pouyaasghari2002/centrifugal-pump-impeller-design/report/main.pdf

## Turbomachinery

# Centrifugal Pump Impeller Design

## Analytical Construction and CFturbo Modeling

Project One Report

## Pouya Asghari

## Niloufar Fattahi

Instructor: Dr. Riasi

Second semester of academic year 1404–1405 (Iranian calendar)

School of Mechanical Engineering

College of Engineering, University of Tehran

English translation of the original Persian report

Centrifugal Pump Impeller Design | Project One

## About this edition

This is an English translation of the supplied Persian project report. The two-phase structure, equations, numerical results, CAD construction sequence, and original substantive figures are retained. Screenshot interface labels and catalog extracts remain as originally supplied. Student identification numbers are omitted, and the coauthorship shown in the source is preserved. The spelling “Niloufar Fattahi” is a transliteration of the Persian author name.

The source uses “simulation” broadly for the CFturbo workflow. The archive documents analytical design, geometry generation, and preliminary software estimates; it does not include a separate CFD mesh, solver case, residual history, or validated flow-field results. Numerical and design claims in the translated body remain the original authors’ statements. An editorial appendix identifies discrepancies and compares the preliminary dimensions with parameters stored in the supplied native CFturbo file. It does not silently replace the original results.

## Contents

1 Introduction | 2
2 Phase One Analytical Design and Blade Construction | 2
3 Phase Two Impeller Modeling in CFturbo | 13
A Editorial Review and Saved Model Comparison | 31

## 1 Introduction

This project aims to develop the geometry, detailed drawings, and three-dimensional model of a centrifugal pump impeller for the 200-100 model, using the operating parameters and technical data in the Pumpiran catalog. The report is organized into two phases. In the first phase, the impeller blade geometry is designed step by step using the single-arc and double-arc methods, based on turbomachinery theory and the extracted pump duty point, and the final profile is drawn. In the second phase, the geometry and operating conditions at the catalog best efficiency point (BEP) are used for specialized pump modeling and simulation in CFturbo to examine flow behavior and design parameters.

## 2 Phase One Analytical Design and Blade Construction

### 2.1 Reference duty point and initial assumptions

The iso-efficiency curves in the Pumpiran catalog are examined at a rotational speed of N = 1450 rpm and an impeller diameter of D2 = 209 mm. The corrected operating coordinates below are adopted as the best efficiency point, with a maximum efficiency of 84.5%.

Volumetric flow rate: Q = 125 m³/h, equivalent to approximately 0.0347 m³/s.

Effective head: H = 13.5 m.

Shaft diameter at the coupling: ds = 32 mm. Allowing for hub thickness, the hub diameter is assumed to be dh = 45 mm.

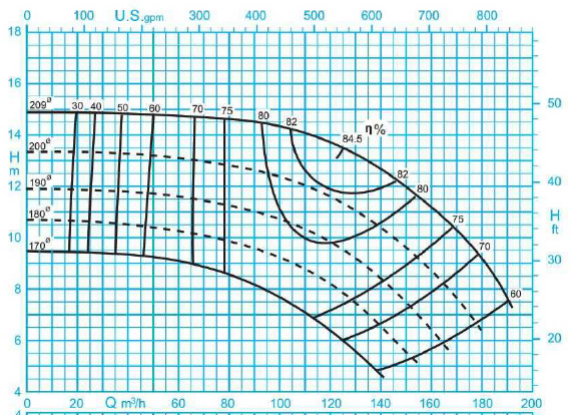
[picture p51: figure]

Figure 1: Pumpiran catalog performance curves used to select the reference duty point.

### 2.1.1 Design assumptions

Hydraulic efficiency: ηh = 0.90.

Volumetric efficiency: ηv = 0.96, allowing for 4% internal leakage.

Blade blockage factors: τ1 = 0.85 at the inlet and τ2 = 0.92 at the outlet.

Number of blades: Z = 6, adopted as a common choice for centrifugal water pumps.

Working fluid: water, with density ρ = 1000 kg/m³

### 2.2 Velocities and principal impeller dimensions

### 2.2.1 Step One Specific speed and theoretical head

The specific speed Ns is used to characterize the overall impeller form:

Ns =

N

√
Q
H⁰.75 =

1450√
0.0347
13.5

0.75 ≈ 38.3.

The source interprets this value as confirming a fully radial centrifugal pump. Applying the hydraulic efficiency gives the theoretical head:

Hth =

H
ηh

=

13.5
0.90

= 15.0 m.

### 2.2.2 Step Two Outlet velocity triangle and outlet angle

The peripheral speed at the outlet diameter D2 = 209 mm is

U2 =

πD2N
60

=

π(0.209)(1450)
60

= 15.87 m/s.

The tangential component of the fluid velocity, Cu2, follows from Euler’s equation:

Hth =

U2Cu2
g

=⇒ Cu2 =

15.0(9.81)
15.87

= 9.27 m/s.

Assuming a blade outlet angle of β

′

2 = 35◦
, the Stodola slip factor is calculated as

σ = 1 −

π sin 35◦

Z

= 1 −

π(0.573)
6

= 0.70.

The ideal tangential velocity is Cu2,∞ = 9.27/0.70 = 13.24 m/s. From the outlet velocity triangle, the outlet meridional velocity is

Cm2 = (U2 − Cu2,∞) tan β

′

2 = (15.87 − 13.24) tan 35◦ = 1.84 m/s.

The corrected flow rate is Q′ = Q/ηv = 0.0361 m³/s. The outlet blade width is therefore

b2 =

Q′

πD2Cm2τ2

=

0.0361
π(0.209)(1.84)(0.92) = 0.032 m = 32 mm.

### 2.2.3 Step Three Inlet dimensions and inlet angle

Taking the suction flange diameter of 125 mm as the reference, the impeller eye diameter is chosen as D1 = 125 mm. The effective inlet area is

A1 =

π
4

(D²
1 − d

2
h

) = π
4

(0.125² − 0.045²

) = 0.0107 m²

The inlet meridional velocity is

Cm1 =

Q′
A1

=

0.0361
0.0107

= 3.37 m/s.

The inlet peripheral speed is

U1 =

πD1N
60

=

π(0.125)(1450)
60

= 9.49 m/s.

Assuming zero inlet prewhirl, Cu1 = 0, the inlet relative-flow angle is

βf1 = arctan

Cm1
U1

= arctan

3.37
9.49
≈ 19.5

◦

Allowing for a suitable incidence angle, the inlet blade metal angle is set to β

′

1 = 25◦

The inlet blade width is

b1 =

Q′

πD1Cm1τ1

=

0.0361
π(0.125)(3.37)(0.85) = 0.032 m = 32 mm.

### 2.3 Blade geometry using single and double arcs

For the SolidWorks construction, the inlet radius is R1 = 62.5 mm and the outlet radius is R2 = 104.5 mm. Blade angles are measured from the tangents to the corresponding circles.

### 2.3.1 Single arc method

In this method, the entire blade profile is represented by one circular arc of constant radius Rarc:

Rarc =

R²

2 − R²
1
2(R2 cos β

′
2 − R1 cos β

′
1

)

Rarc =

104.5

2 − 62.5

2
2(104.5 cos 35◦ − 62.5 cos 25◦)

≈ 120.9 mm.

The source specifies a single-arc blade radius of 120.9 mm, with the arc center located at a radial distance of 69.6 mm from the shaft center.

Construction procedure First, draw two concentric circles with radii R1 and R2 in Solid-Works.


Figure 2: Concentric inlet and outlet circles for the single arc construction.

Choose an arbitrary point B on the outer circle and join it to the common center O. Select a point K on the inner circle so that ∠BOK = β

′
1 + β

′
2

:

β

′
1 + β

′

2 = 25◦ + 35◦ = 60◦


Figure 3: Selection of points B, O, and K with a central angle of 60 degrees.

Join B to K and extend the line until it intersects the inner circle again; call this intersection A. Draw the perpendicular bisector of BA. From B, draw a line at an angle β

′
2

to BO so that it
intersects the perpendicular bisector at G. Finally, draw an arc from B to A centered at G.


Figure 4: Single arc construction using the perpendicular bisector and center G.

To check the constructed arc, extend both ends and measure their angles relative to the circle tangents. As shown below, the source obtains the specified inlet and outlet angles, β

′
1

and β

′
2


Figure 5: Checking the inlet and outlet angles of the single arc profile.

Six blades are required. Use the Circular Sketch Pattern tool in SolidWorks to repeat the arc five more times.


Figure 6: Six blade profiles generated with Circular Sketch Pattern.

The following drawing also shows the inlet and outlet angles used in the construction.


Figure 7: Single arc blade construction with angle checks.

### 2.3.2 Double arc method

To improve flow guidance, the blade is divided into two sections. The source calls the intermediate radius Rm the geometric mean of the radii and defines it using the following expression:

Rm =

s
R²

1 + R²
2
2

= 86.1 mm.

With linear interpolation, the blade angle at the intermediate point is βm = 30◦ .

The first, inner arc extends from radius 62.5 mm at an angle of 25◦ to radius 86.1 mm at an
angle of 30◦
. The source calculates its radius as Rarc1 = 97.7 mm.

The second, outer arc extends from radius 86.1 mm at 30◦

to radius 104.5 mm at 35◦
. Its
reported radius is Rarc2 = 159.1 mm.

Construction procedure First, calculate δ using the procedure in the course’s impeller design video:

δ = D1 sin β

′

1 = 125 sin 25◦ = 52.827 mm.

Draw a circle of diameter δ centered at O, in addition to the two principal circles.


Figure 8: Auxiliary circle of diameter delta for the double arc construction.

Mark six points on the inner circle, and from each point draw a tangent to the circle of diameter δ.


Figure 9: Tangents drawn from the inlet circle to the auxiliary circle.

Using the tangent lengths as radii and the corresponding tangency points on the smallest circle as centers, draw circular curves. Continue each curve until it meets the extension of the next tangent. Each resulting segment forms part of the complete blade profile.


Figure 10: Construction of the initial curved segments.

Trim the unused portions of the circles.


Figure 11: Initial blade segments after trimming the auxiliary circles.

The partial blade profile is now visible. To continue the construction, determine the remaining arc radius ρ using

ρ =

1
2

R²

2 − R²
F
R2 cos β

′
2 − RF cos β

′
F

Here, RF is the distance from the impeller center to the end of the constructed curve. The source describes the relevant angle as the angle between RF and the line joining the curve endpoint to the first point on the δ circle, but labels it β

′
2

in this sentence. On that connecting line, locate point G a distance ρ from the curve endpoint, then draw a circle centered at G with radius ρ to join the curve to the outer circle. See the editorial note on the angle-label inconsistency.


Figure 12: Determination of the intermediate endpoint and connecting arc.

From the SolidWorks drawing above, the unknown quantities are obtained as

RF = 82.30 mm,

β

′

F = 5.26◦

ρ =

1
2

104.5

2 − 82.30²
104.5 cos 35◦ − 82.30 cos 5.26◦

=⇒ ρ = 568.39 mm.

Thus, locate the center a distance ρ from the end of the existing curve and draw a circle of radius ρ.


Figure 13: Construction of the final arc of radius 568.39 mm.

Trim the extra portions and check the inlet and outlet angles.


Figure 14: Angle checks after trimming the final connecting arc.

The drawing shows the specified inlet and outlet angles. The blade profiles are then redrawn without the auxiliary construction geometry.


Figure 15: Completed blade profiles without construction lines.

Table 1: Blade metal and relative-flow angles reported in Phase One.

Parameter | Value | Description

Inlet metal angle β

′

1 | 25◦ | Blade construction angle, including 5.5

◦
inci-
| | dence.
Outlet metal angle β

′

2 | 35◦ | Outlet construction angle used to draw the blade arc.
Inlet flow angle β1 | 19.5
- Relative inlet direction from the velocity triangle.
Outlet flow angle β2 | 15.6
- Actual relative outlet direction including slip.

## 3 Phase Two Impeller Modeling in CFturbo

After the initial geometric design in Phase One, Phase Two addresses the three-dimensional modeling and detailed simulation of the 100-200 pump impeller in CFturbo. The source describes the software as converting the extracted operating parameters and dimensions into a detailed CAD model and predicting the pump’s fluid behavior.

### 3.1 Entering the duty point

The CFturbo workflow starts by defining the pump operating conditions. The Phase One values for the best efficiency point are entered into the software:

Working fluid: water at the reference temperature, with a density of 1000 kg/m³

Rotational speed: N = 1450 rpm.

Volumetric flow rate: Q = 125 m³/h, equivalent to approximately 0.0347 m³/s.

Developed head: H = 13.5 m.

From these inputs, CFturbo calculates the specific speed and identifies the turbomachine as a radial centrifugal pump.


Figure 16: CFturbo global setup at the adopted duty point.

The proposed machine type is shown as Radial (medium pressure). The hydraulic efficiency was taken as 90% in Phase One, so the same value is entered here.


Figure 17: Duty point and efficiency settings.

From Add Component, choose Radial/Mixed-flow Impeller. Then select the options shown in the Setup tab of Main Dimensions. The source leaves Unshrouded unchecked so that the impeller has a front shroud, explaining this choice in terms of the water-pump application. Splitter Blades is also left unchecked; the source states that the pump size does not require additional outlet flow guidance of that type.


Figure 18: Radial impeller setup options.

In the Parameters tab, the default values are initially retained because they lie in suitable regions of the displayed parameter curves. The manually calculated value of b2/D2, however, falls outside the indicated recommended region and is considered unsuitable.


Figure 19: Initial parameter choices and warning messages.


Figure 20: Parameter chart for the outlet width ratio.

The b2/D2 parameter is therefore also returned to its default value.


Figure 21: Parameters after restoring the default width ratio.

In the Dimensions tab, select the shaft specification. The Pumpiran catalog lists Ck45 steel as the shaft material for the 100-200 pump.

Figure 22: Catalog material specification for the shaft, impeller, and casing.

The corresponding allowable stress is selected.

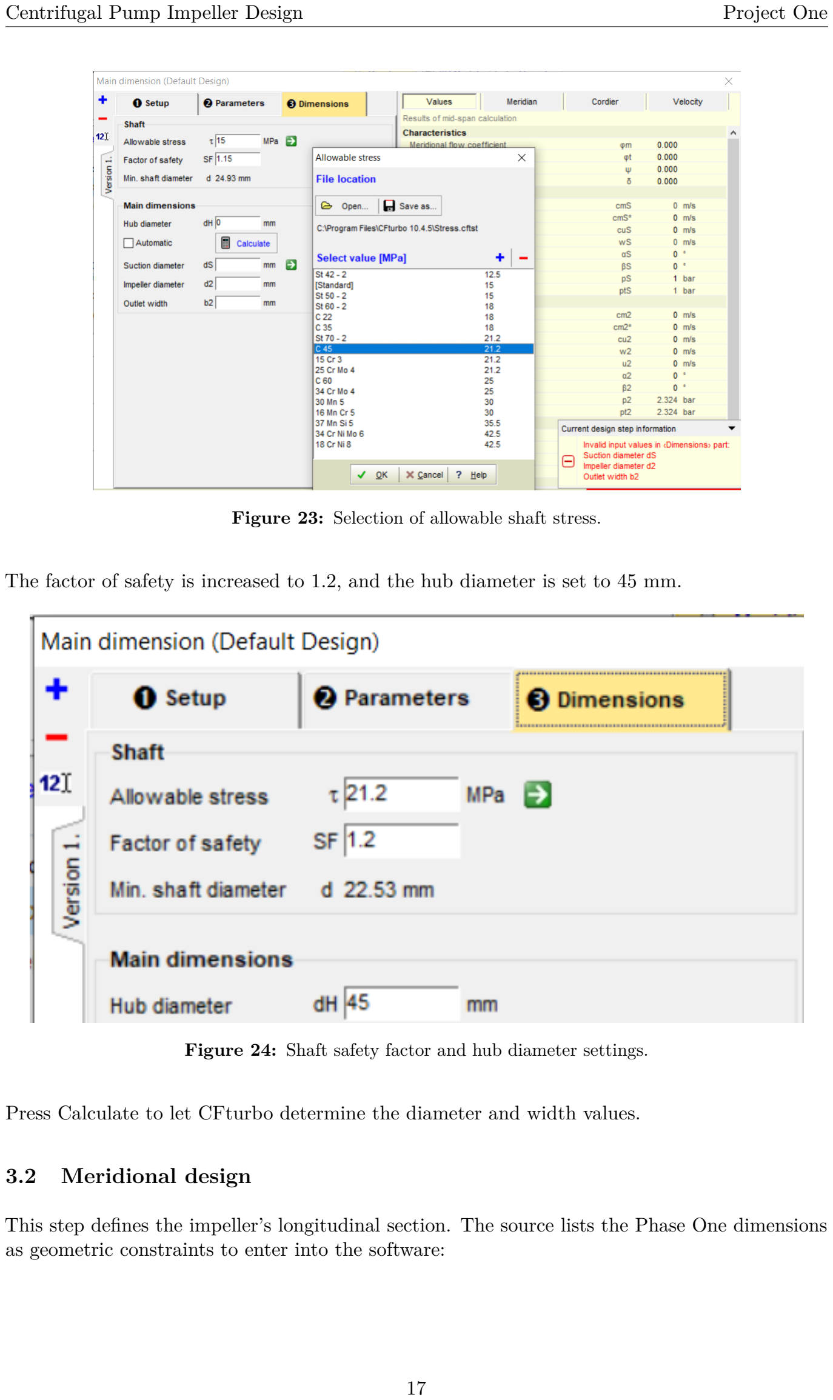
[picture p52: page 18]

Figure 23: Selection of allowable shaft stress.

The factor of safety is increased to 1.2, and the hub diameter is set to 45 mm.

Figure 24: Shaft safety factor and hub diameter settings.

Press Calculate to let CFturbo determine the diameter and width values.

### 3.2 Meridional design

This step defines the impeller’s longitudinal section. The source lists the Phase One dimensions as geometric constraints to enter into the software:

Table 2: Phase One dimensions listed as intended CFturbo inputs in the source.

Dimension | Symbol | Reported value
Shaft diameter | ds | 32 mm; hub diameter 45 mm
Impeller eye diameter | D1 | 125 mm
Impeller outlet diameter | D2 | 209 mm
Inlet blade width | b1 | 32 mm
Outlet blade width | b2 | 32 mm

The dimensions initially calculated by CFturbo are shown below.

Figure 25: Initial main dimensions proposed by CFturbo.

The source states that only the shaft diameter differs substantially from the Phase One values and proposes adjusting it using the standard diameter in the catalog. The following figures and the DN designation refer to the suction connection; this terminology conflict is addressed in the editorial appendix.


Figure 26: Catalog drawing showing the DN 125 suction connection.

From the Pumpiran catalog drawing above, the source identifies DN 125 as the standard nominal diameter.


Figure 27: Selection of a standard suction diameter.

The resulting parameter values are shown below.


Figure 28: Main dimension settings after adjustment.

The Cordier diagram available in the same dialog places the selected design point between the two red curves. The source treats this as an indication that the design is acceptable.


Figure 29: Cordier diagram for the selected operating point.

The velocity triangles are shown below.


Figure 30: CFturbo inlet and outlet velocity triangles.

The impeller hub and shroud contours are adjusted using Bezier curves in CFturbo, aiming for a smooth variation of passage area and avoiding abrupt changes in velocity.


Figure 31: Initial meridional contour and diagnostic plots.

Alongside the meridional blade view, the software displays Curvature, Cross Section Area, and Static Moment plots. The source states that lower specific speed calls for a straighter meridional centerline, while higher specific speed allows a more concave profile, as in this design. The cross-sectional area curve should preferably be smooth, with no sudden jumps; the initial geometry already satisfies this visual criterion. The two static-moment curves should preferably be close to each other. Small adjustments to the Bezier control points improve this plot.


Figure 32: Meridional diagnostic plots after adjusting the Bezier curves.

The impeller is mounted on the shaft using a shaft-end nut. On the suction side, this nut occupies part of the inlet flow area. The source therefore extends the hub contour forward relative to the shroud contour, aiming to reduce the obstruction of the effective suction area and improve entry into the flow passage.


Figure 33: Hub contour extended toward the inlet relative to the shroud.

### 3.3 Blade angles and thickness distribution

This is identified as the principal blade-design step in CFturbo. The geometric angles calculated in Phase One are initially specified as follows:

Number of blades: six.

Inlet blade metal angle: β

′

1 = 25◦

Outlet blade metal angle: β

′

2 = 35◦

The blade-angle distributions from inlet to outlet on the hub and shroud surfaces are refined using CFturbo’s conformal-mapping diagrams. The source also describes a gradual thickness distribution for the cast-iron blades, with a thinner leading edge to reduce incidence and blockage and a thicker trailing edge for mechanical strength.

With a specific speed of approximately 38, the source adopts the course recommendation to use Free-form 3D geometry above a specific speed of 15. Although this option is more expensive to manufacture than a two-dimensional blade, the source expects better efficiency and describes the choice as a tradeoff between efficiency and cost.

The proposed blade thickness range is 3.2–3.7 mm. A value of 3.4 mm is selected at the hub for both the leading and trailing edges, while 3.2 mm is selected at the shroud to create a spanwise thickness gradient. The source explains that this gradient facilitates removal from a casting mold compared with a uniformly thick blade. The blade count remains six, and Number of Spans is set to seven. The source treats this setting as a finer geometric subdivision rather than a change to the other design parameters. The remaining choices are shown below.

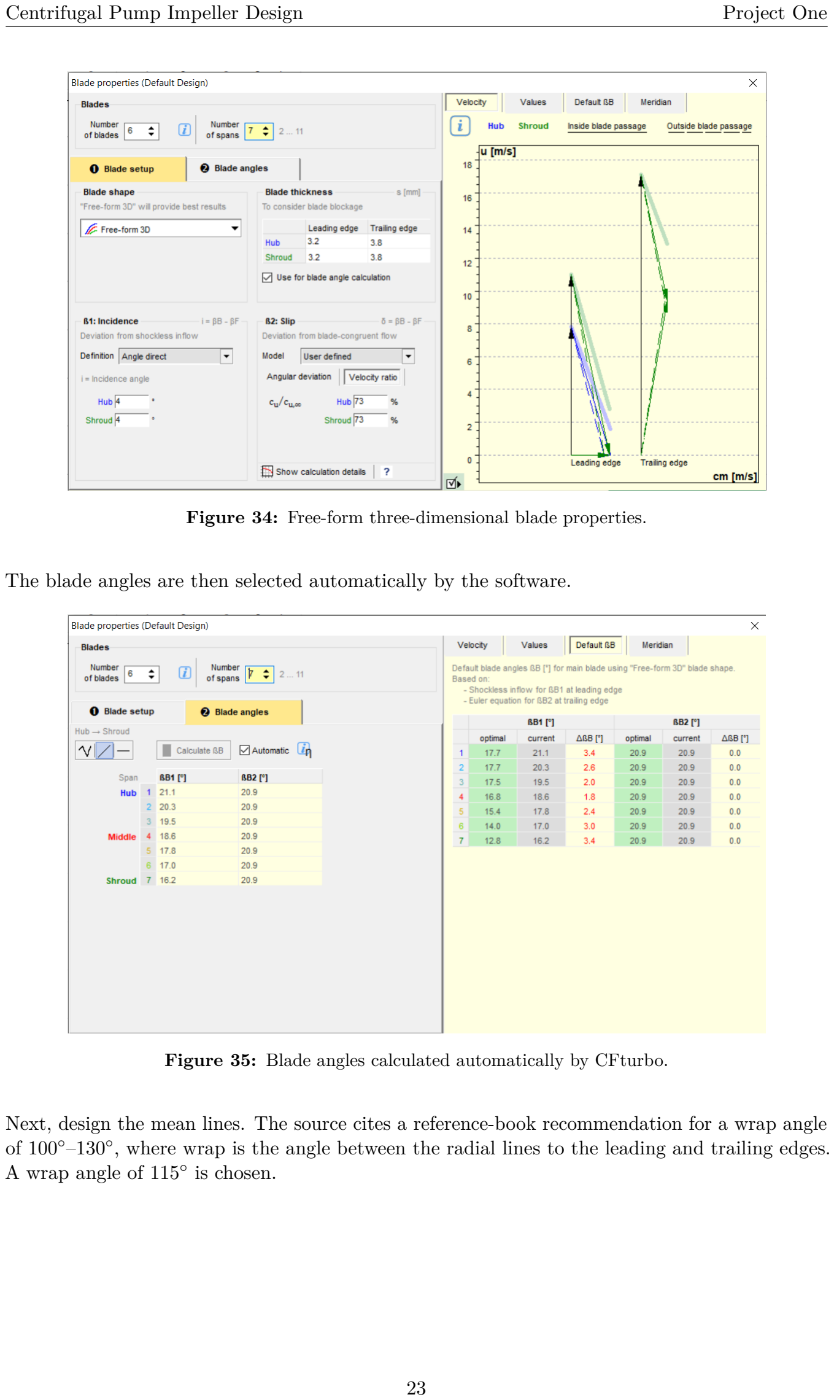
[picture p53: page 24]

Figure 34: Free-form three-dimensional blade properties.

The blade angles are then selected automatically by the software.

Figure 35: Blade angles calculated automatically by CFturbo.

Next, design the mean lines. The source cites a reference-book recommendation for a wrap angle of 100◦–130◦
, where wrap is the angle between the radial lines to the leading and trailing edges. A wrap angle of 115◦
is chosen.

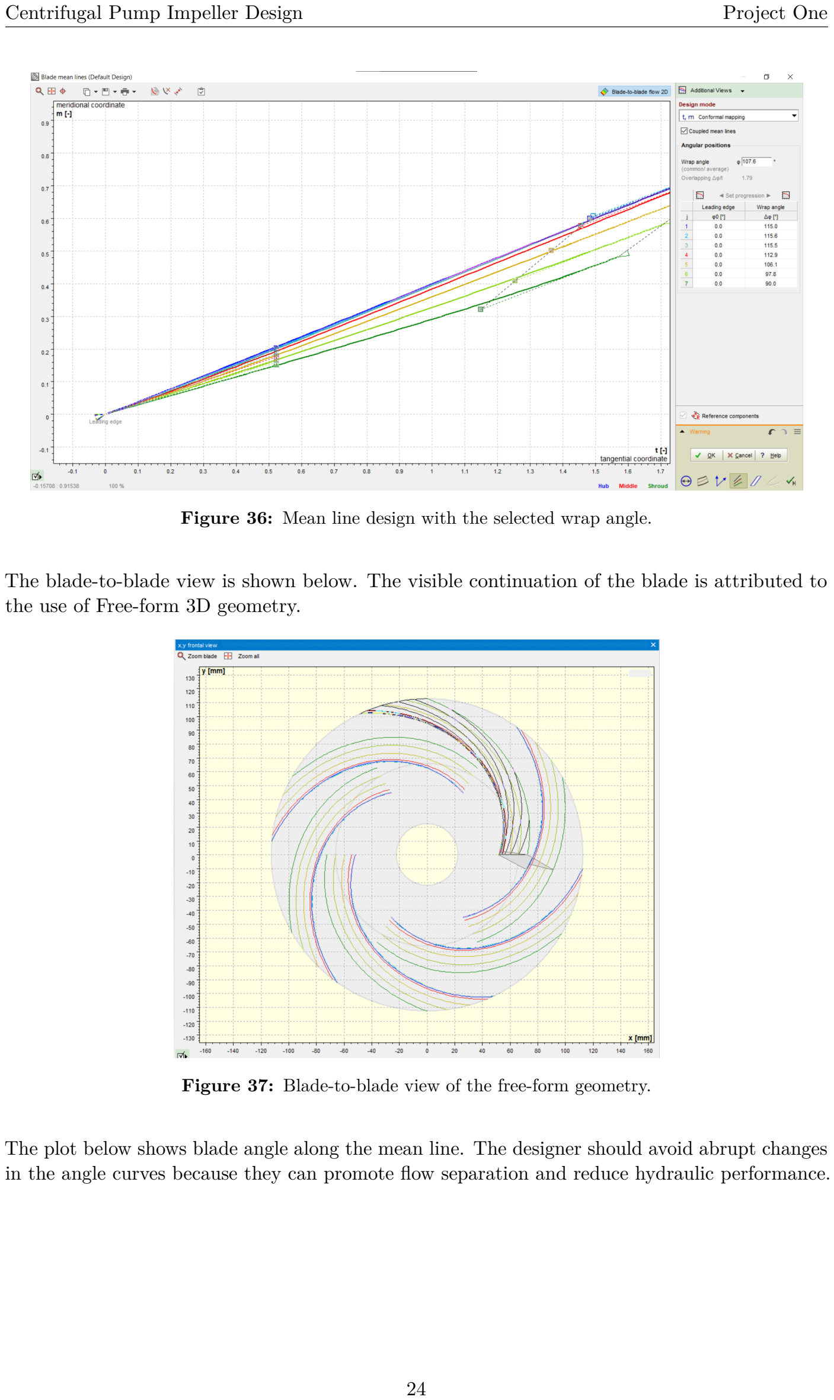
[picture p54: page 25]

Figure 36: Mean line design with the selected wrap angle.

The blade-to-blade view is shown below. The visible continuation of the blade is attributed to the use of Free-form 3D geometry.

Figure 37: Blade-to-blade view of the free-form geometry.

The plot below shows blade angle along the mean line. The designer should avoid abrupt changes in the angle curves because they can promote flow separation and reduce hydraulic performance.


Figure 38: Blade angle distributions along the mean lines.

### 3.4 Leading and trailing edge design

Blade-edge location directly affects hydraulic behavior. The leading edge is placed in the impeller eye region, and the trailing edge at the outer diameter D2. The source describes inclined edge geometry as a way to reduce stress concentration and provide smoother fluid entry.

The source recommends rounded, blade-like edge profiles rather than blunt, flat edges, describing the latter as producing stagnation and reduced hydraulic performance. It also calls for similar edge shapes from hub to shroud. These qualitative design statements are retained from the original report.


Figure 39: Leading and trailing edge profile settings.

Figure 40: Repeated edge-design view retained from the original report.

The same blade-like profile can also be observed in the front view.


Figure 41: Front view of the blade edge geometry.

### 3.5 Preliminary assessment in CFturbo

The source presents the CFturbo stage as an initial performance assessment and geometric-design check before more detailed CFD analysis.

The final three-dimensional impeller geometry can now be viewed.


Figure 42: Three-dimensional view of the impeller design.


Figure 43: Top view of the impeller geometry.


Figure 44: Side detail of the impeller geometry.

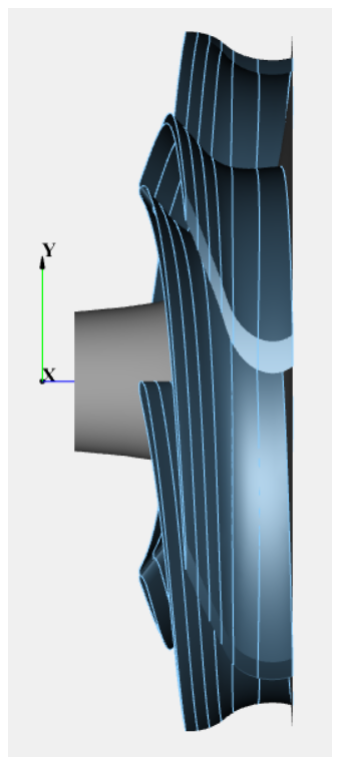
[picture p55: figure]

Figure 45: Axial side view of the impeller.

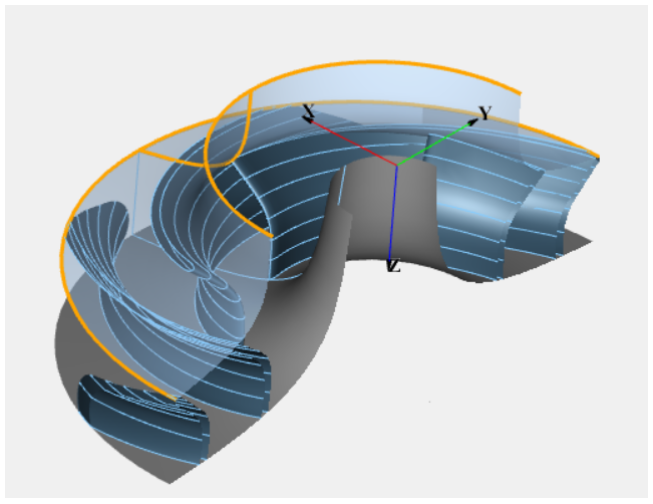
[picture p56: figure]

Figure 46: Perspective detail showing the blade passage.

Under Impeller, open Model Finishing and select Extend Blade Only.


Figure 47: Model finishing with Extend Blade Only selected.

Export the model in STEP and SWB formats.

### 3.6 Assessment objectives and workflow

Velocity and pressure assessment. The source describes analytical and semi-empirical estimates of relative velocity and static pressure along the interblade passage, intended to help identify regions susceptible to abrupt pressure reduction.

Cavitation assessment. The source discusses examining low-pressure regions near the leading edge and estimating the required net positive suction head, NPSHr. For this pump, the design should be checked so that the local pressure does not fall below the vapor pressure of water. The figure below contains empirical NPSHr estimates; it does not establish a resolved cavitating-flow simulation.

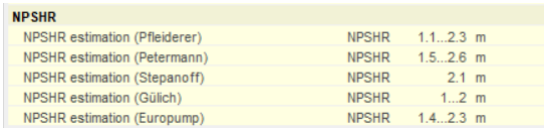
[picture p57: figure]

Figure 48: Empirical NPSHr estimates displayed by CFturbo.

Blade loading. The source proposes examining the pressure difference between the suction and pressure surfaces. A smooth loading distribution is described as desirable for limiting separation losses. An abrupt reduction in loading would motivate revising the blade-angle curves. No resolved blade-pressure dataset is supplied in the archive.

Three-dimensional outputs and model transfer. After reviewing the preliminary calculations, dimensions, and angles, the final impeller geometry is prepared for CAD export. Standard formats such as STEP or IGES can transfer geometry to fluid-analysis environments such as ANSYS CFX or Fluent, or to CAD systems such as SolidWorks. The supplied archive contains STEP and SWB exports; IGES and downstream CFD cases are not included.


Figure 49: CAD views of the impeller after geometry transfer.

The source concludes that the final CFturbo model agrees reasonably with the Phase One calculations and offers a basis for physical manufacture or more detailed numerical testing. This conclusion is retained as the authors’ assessment; the saved-model differences and the absence of independent validation are documented in the editorial appendix.

## A Editorial Review and Saved Model Comparison

This appendix was added during English preparation. It distinguishes the source report from values inspected in the supplied files. The CFturbo and SolidWorks projects have not been opened or recomputed in their native applications.

A.1 Project scope and validation status

The archive contains one Persian report, a CFturbo design file, a STEP export, a SolidWorks macro, two main SolidWorks parts, and two further parts in a folder named Junk. No CFD solver project, mesh, flow-field dataset, or experimental test results were supplied. Empirical NPSHr estimates and geometric diagnostic curves do not demonstrate a cavitation simulation or validate pump performance. The quoted 84.5% catalog efficiency is a source datum, while the 90% hydraulic efficiency is a design assumption; neither is a measured efficiency of the new impeller.

The source identifies the pump as both 200-100 and 100-200. The repository uses the descriptive project name instead of asserting that these are distinct pump models. The full Pumpiran catalog and the unspecified course reference book were not supplied as standalone references.

A.2 Hand calculations and terminology

The source’s single arc formula gives approximately 121.11 mm when evaluated using R1 = 62.5 mm, R2 = 104.5 mm, β

| ′

1 = 25◦
, and β

′

2 = 35◦
, rather than the stated 120.9 mm. This small discrepancy should be reconciled with the exact sketch dimensions before manufacturing use.

The expression q
(R²
1 + R²
2

)/2 = 86.1002 mm is the root mean square of the radii, not their geometric mean. The geometric mean would be √
R1R2 = 80.8161 mm. The source’s expression and reported 86.1 mm are retained in the translated body.

Using the same arc-radius formula with the stated intermediate radius and angles gives about 97.85 mm and 158.88 mm, close to the reported 97.7 mm and 159.1 mm. The later tangent-based drawing uses a different continuation construction and a radius of 568.39 mm. These are different constructions in the source; the report does not establish their equivalence.

For that final continuation, the angle associated with RF is β

′
F = 5.26◦
. The explanatory source
sentence calls it β

′
2

, although β

′

2 = 35◦
is the separate outlet angle. The displayed equation and the reported 568.39 mm use the intended β

′
F

notation.

The specific speed near 38.36 uses N in rpm, Q in m³/s, and H in meters. This is the conventional European-style specific-speed value often denoted nq; numerical specific-speed values depend on the unit convention and should not be compared across conventions without conversion.

A.3 Suction connection and shaft diameter

DN 125 describes the nominal suction connection shown in the catalog drawing; it is not a shaft diameter. The source separately gives a 32 mm coupling-shaft diameter and a 45 mm hub diameter. In the CFturbo main-dimensions interface, the suction-diameter field and the shaft sizing section are separate. The source’s narrative confuses them during the standard-diameter selection step.

A catalog flange designation also does not by itself require the internal impeller eye diameter to be exactly 125 mm. That value is an assumption in the preliminary hand design. A point within the displayed Cordier recommendation region is a design heuristic, not independent hydraulic or mechanical validation.

A.4 Parameters stored in the native CFturbo project

The project XML records CFturbo version 10.4.5.27, with format version 10.4. Its global setup stores a rotational frequency of 24.1667 s

−1
(1450 rpm), a mass flow of 34.7222 kg/s, density 1000 kg/m³

, and specific energy 132.435 J/kg. These correspond to 125 m³/h and a head of 13.5 m using g = 9.81 m/s

2

The following are stored parameter values, not independently regenerated geometry measurements:

Table 3: Preliminary design versus the supplied saved CFturbo state.

Quantity | Preliminary report | Saved project
Outlet diameter | 209 mm | 225.8 mm
Outlet width | 32 mm | 34.55 mm
Eye or suction diameter | Eye assumed 125 mm | Suction field 132.5 mm
Hub diameter | 45 mm | 45 mm
Blade count | 6 | 6
Span count | 7 in CFturbo stage | 7
Blade form | Free-form 3D selected | FreeForm
Shroud and splitters | Shrouded, no splitters | Same settings
Hydraulic efficiency | 0.90 assumption | Global EtaC 0.90; component
| | EtaH 0.912

The saved component stores inlet-angle entries of approximately 21.10◦ and 16.17◦
, and outlet-angle entries of approximately 20.89◦ at both listed endpoints. The preliminary 25◦ and 35◦ angles therefore do not describe the final saved blade-angle values. This is consistent with the narrative later allowing automatic angle calculation, but the stages must not be presented as identical.

Similarly, the saved thickness arrays contain 3.2 mm entries for s1 and 3.8 mm entries for s2, which differ from the prose’s proposed hub and shroud values. Their exact leading/trailing and span assignments should be confirmed in CFturbo before claiming a particular final thickness distribution. The native file also stores some empirical coefficients independently of the resulting manually adjusted dimensions; a saved coefficient should not be assumed to equal a ratio recomputed from all final dimensions.

A.5 CAD deliverables and reproducibility

The STEP export contains solid-body, surface, and curve entities. It should not be described as one verified watertight manufacturing solid merely because the filename ends in .stp. The native SolidWorks part files have not been inspected in SolidWorks, so their association with a particular blade construction is not inferred from generic names such as Part1 and Part2.

The .swb file is an ASCII SolidWorks macro generated by CFturbo 10.4.5, with a main entry point. It creates geometric features and requires SolidWorks; it is not a standalone numerical simulation program. Original CAD bytes are retained in the repository package, including the separately labeled archive parts in Solidworks/Junk.

To reproduce the final design, open a copy of the native project in a compatible CFturbo installation, record its settings, and compare its geometry with the existing exports before saving.

CFturbo’s documented automatic calculations can alter values when old projects are opened in newer software. The software version, unit conventions, and saved design stage should therefore be recorded with any new export. Validate downstream CAD import and topology before using the geometry for meshing or manufacture.

A.6 Documentation consulted during editorial review

The following official CFturbo pages were consulted to clarify terminology and workflow. They are editorial references, not a replacement for the original catalog or course references.

1. CFturbo Turbomachinery Design Software. (https://manual.cfturbo.com/en/cfturbo.html)
2. Centrifugal and mixed-flow pump parameters. (https://manual.cfturbo.com/en/md_parameters_pumpvent.html)
3. Specific speed definitions and unit conventions. (https://manual.cfturbo.com/en/prefunits_nq.html)
4. Automatic calculations and opening older projects. (https://manual.cfturbo.com/en/automatic_updates.html)
5. BLADERUNNER and downstream CFD simulation workflow. (https://manual.cfturbo.com/BLADERUNNER/index.html)
