pouyaasghari2002/centrifugal-pump-impeller-design/cad/CFTurbo/Proj1.stp

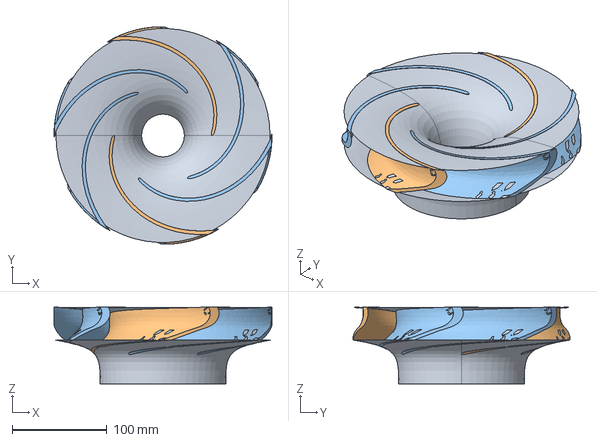
[picture p58: CAD file, 2026-10-24]
cad/CFTurbo/Proj1.stp
229.9 x 229.4 x 81.1 mm
