pouyaasghari2002/centrifugal-pump-impeller-design/(list of files, cad)

Other CAD files:
cad/Solidworks/Junk/Part2.SLDPRT
cad/Solidworks/Part1.SLDPRT
cad/Solidworks/Junk/Part1.SLDPRT
cad/Solidworks/Part2.SLDPRT
